jnslmk/freecad-models/led_profiles/stella/print/StellaOffsetCore-Organic offset triangular connector — three integrated saddles.stl

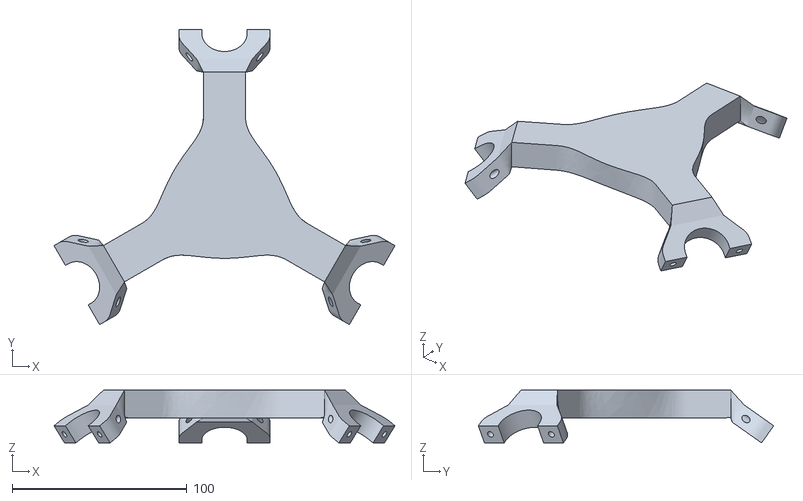
[picture p1: CAD file, 2026-09-25]
led_profiles/stella/print/StellaOffsetCore-Organic offset triangular connector — three integrated saddles.stl
195.0 x 168.9 x 30.2
