jnslmk/freecad-models/led_profiles/stella/stella_profile_sources/endcap_near.step

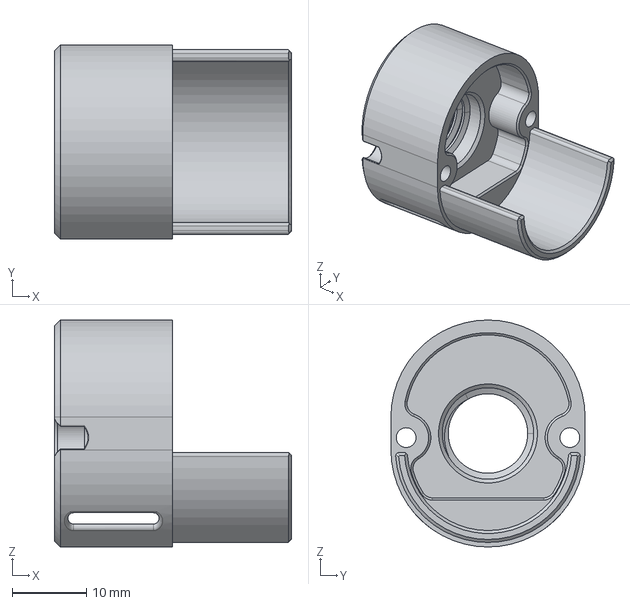
[picture p2: CAD file, 2026-09-22]
led_profiles/stella/stella_profile_sources/endcap_near.step
31.9 x 26.1 x 30.5 mm
