jnslmk/freecad-models/led_profiles/stella/stella_profile_sources/profile_diffuser.step

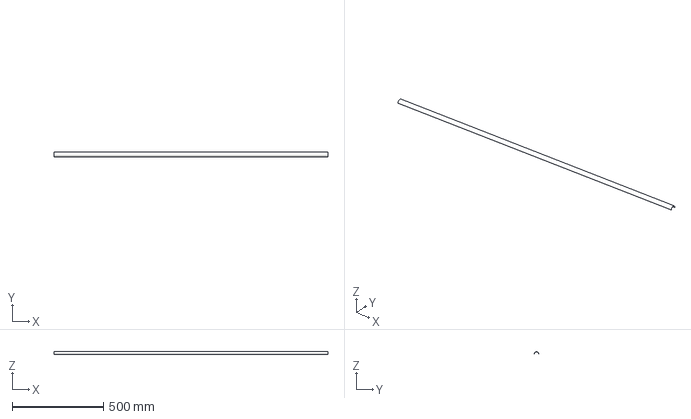
[picture p3: CAD file, 2026-09-22]
led_profiles/stella/stella_profile_sources/profile_diffuser.step
1500.0 x 26.1 x 13.7 mm
