jnslmk/freecad-models/led_profiles/stella/StellaCore.FCStd

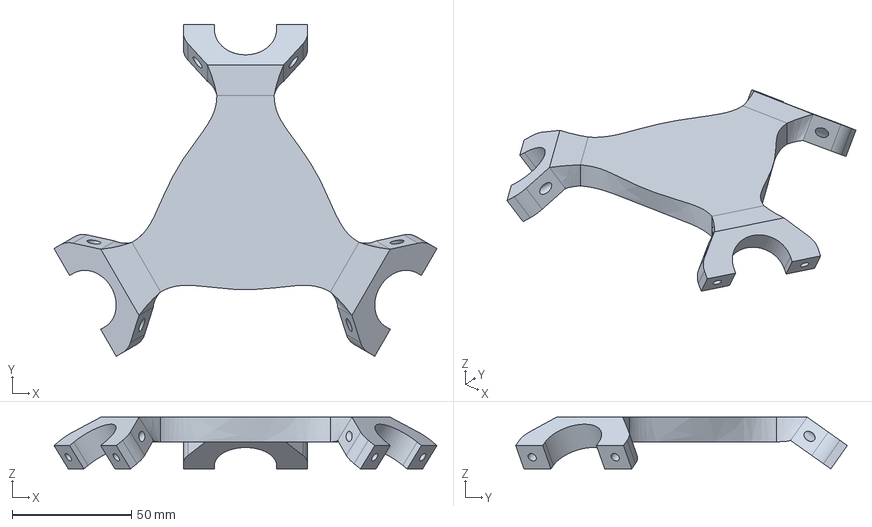
[picture p4: CAD file, 2026-09-25]
led_profiles/stella/StellaCore.FCStd
160.5 x 139.0 x 21.7 mm
