jnslmk/freecad-models/led_profiles/stella/stella_profile_sources/cable_far.step

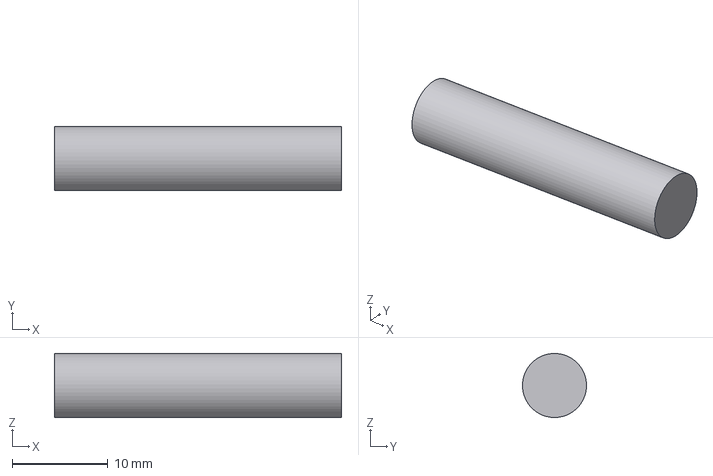
[picture p5: CAD file, 2026-09-22]
led_profiles/stella/stella_profile_sources/cable_far.step
30.0 x 6.70 x 6.69 mm
