jnslmk/freecad-models/led_profiles/stella/StellaOctangula.FCStd

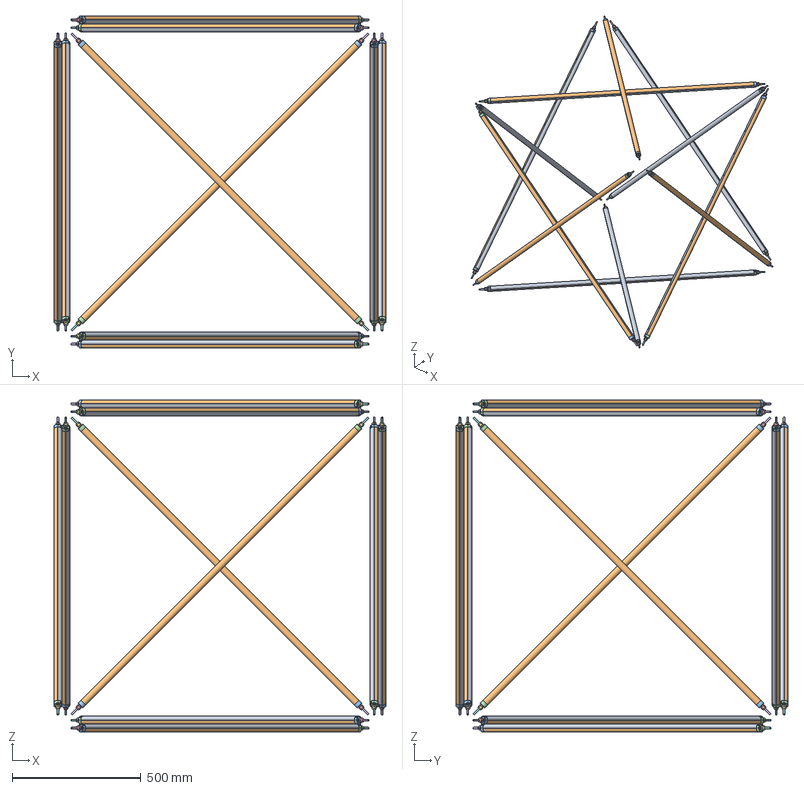
[picture p6: CAD file, 2026-09-24]
led_profiles/stella/StellaOctangula.FCStd
1288.4 x 1288.4 x 1288.4 mm
Aluminium profile x 12
Diffuser x 12
Near endcap x 12
Far endcap x 12
Near cable gland x 12
Near cable stub x 12
Far cable gland x 12
Far cable stub x 12
