jnslmk/freecad-models/led_profiles/stella/StellaProfileClamp.FCStd

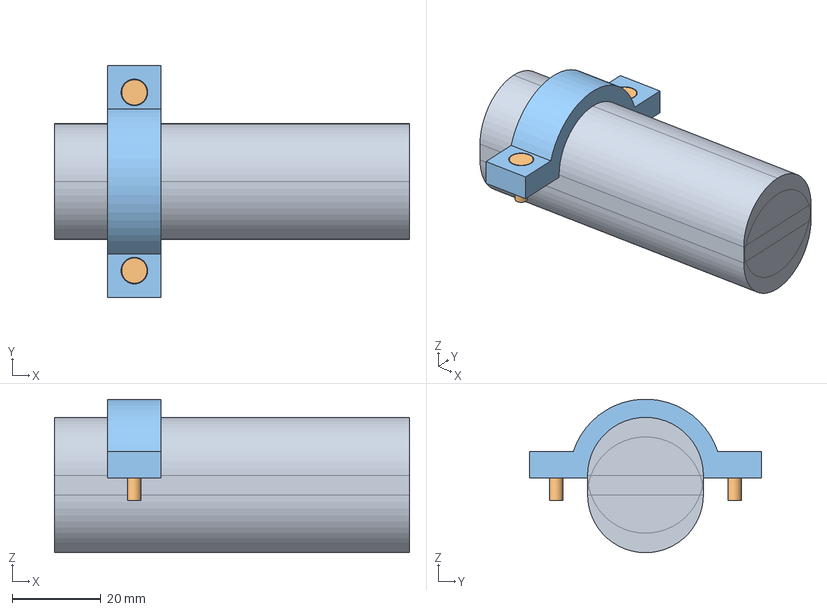
[picture p7: CAD file, 2026-09-24]
led_profiles/stella/StellaProfileClamp.FCStd
80.0 x 52.2 x 34.6 mm
Reference-only measured LED profile — 26.1 × 30.5 mm
Two M3 × 8 socket-head screws — clamp-side insertion reference
Simplified Stella profile clamp
