jnslmk/freecad-models/led_profiles/stella/stella_profile_sources/gland_near.step

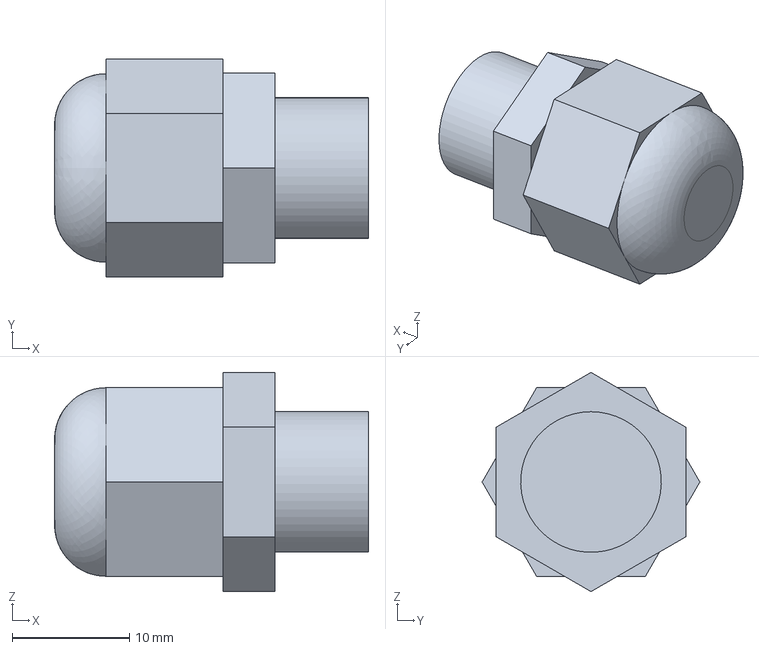
[picture p8: CAD file, 2026-09-22]
led_profiles/stella/stella_profile_sources/gland_near.step
26.8 x 18.6 x 18.7 mm
