jnslmk/freecad-models/led_profiles/stella/stella_profile_sources/profile_extrusion.step

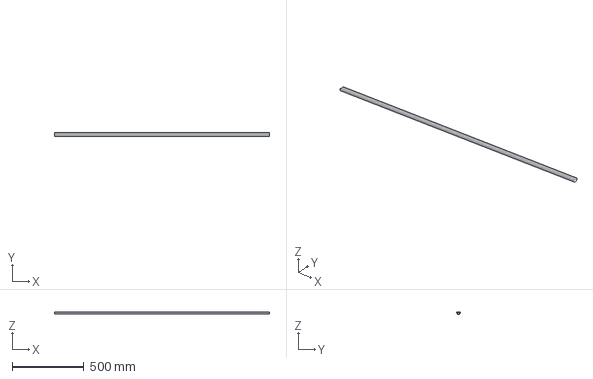
[picture p9: CAD file, 2026-09-22]
led_profiles/stella/stella_profile_sources/profile_extrusion.step
1500.0 x 26.1 x 16.8 mm
