jnslmk/freecad-models/(list of files, cad)

Other CAD files:
led_profiles/stella/StellaOffsetCore.FCStd
led_profiles/stella/stella_profile_sources/cable_near.step
led_profiles/stella/stella_profile_sources/endcap_far.step
led_profiles/stella/stella_profile_sources/gland_far.step
led_profiles/stella/print/StellaCore.stl
