jnslmk/freecad-models/(commit log)

2026-09-22 chore: initialize freecad models repository
    [StellaArm.FCStd, StellaArm.before-scope-fix.FCStd, StellaCore.FCStd, StellaOctangula.FCStd]
2026-09-22 fix(stella): harden assembly rebuild workflow
2026-09-22 feat(stella): add profile clamp assembly
    [StellaArm.FCStd, StellaCore.FCStd, StellaProfileClamp.FCStd]
2026-09-22 refactor(stella): simplify profile clamp tree
    [StellaProfileClamp.FCStd]
2026-09-22 feat(stella-arm): add arm mounting features
    [StellaArm.FCStd]
2026-09-22 refactor(stella-clamp): remove duplicate primitives
    [StellaProfileClamp.FCStd]
2026-09-22 refactor(stella): pattern core seats
    [StellaCore.FCStd, StellaCore.before-simplification.FCStd]
2026-09-22 chore(stella): update arm model
    [StellaArm.FCStd]
2026-09-22 feat(stella): assemble complete profile sources
    [StellaArm.FCStd, StellaOctangula.FCStd, StellaOctangula.before-full-profile.FCStd, StellaOctangula.before-validation-note.FCStd, cable_far.step, cable_near.step, endcap_far.step, endcap_near.step]
2026-09-23 docs(stella): record assembly design baseline
    Capture native source-of-truth objects, fixed interfaces, measured fit gaps, and useful views before revising geometry. No authoritative FCStd document is changed.
2026-09-23 feat(stella): stage clamped assembly review
    Seat linked arms against the intended 12 mm core, include 24 linked native clamps, and reject joint gaps or clamp interference. Preserve the four authoritative FCStd files; save a separate functional working copy and an unselected native-filleted clamp concept. Envelope, crossings, and cable route remain open decisions.
    [StellaOctangula-12mm-clamps.FCStd, StellaOctangula-ConceptA.FCStd, StellaProfileClamp-ConceptA.FCStd]
2026-09-23 feat(stella): accept offset-core assembly
    [StellaArm.FCStd, StellaArm.stl, StellaCore.FCStd, StellaCore.stl, StellaCoreSimple.FCStd, StellaOctangula-12mm-clamps.FCStd, StellaOctangula-ConceptA.FCStd, StellaOctangula-before-12mm-acceptance.FCStd]
2026-09-24 feat(stella): publish compact simple assembly
    [StellaCoreSimple-Compact-PETG.FCStd, StellaCoreSimple-ConceptA.FCStd, StellaCoreSimple-ConceptB.FCStd, StellaCoreSimple-Offset-Compact-PETG.FCStd, StellaCoreSimple-Offset-before-bolted-clamps-20260923.FCStd, StellaCoreSimple-Offset.FCStd, StellaCoreSimple-before-bolted-clamps-20260923.FCStd, StellaCoreSimple-before-channel-clearance-20260923.FCStd]
2026-09-24 chore(stella): consolidate canonical models
    [StellaArm.FCStd, StellaArm.before-scope-fix.FCStd, StellaCore.FCStd, StellaCore.before-simplification.FCStd, StellaCoreSimple-Compact-PETG.FCStd, StellaCoreSimple-ConceptA.FCStd, StellaCoreSimple-ConceptB.FCStd, StellaCoreSimple-Offset-Compact-PETG.FCStd]
2026-09-24 docs(agents): use one-document CAD reviews
2026-09-24 feat(stella): integrate mirrored saddle mounts
    [StellaCore.FCStd]
2026-09-24 fix(stella): keep insert pilots centered in grips
    [StellaCore.FCStd]
2026-09-24 docs(cad): require relational design constraints
2026-09-24 feat(stella): parameterize base triangle height
    [StellaCore.FCStd]
2026-09-24 feat(stella): bridge web to clamp with pipe
    [StellaCore.FCStd]
2026-09-24 fix(stella): align offset core clamps
    [StellaOctangula.FCStd, StellaOffsetCore.FCStd]
2026-09-25 fix(stella): add through-hole clamp bores
    [StellaCore.FCStd, StellaCore.stl, StellaOffsetCore.FCStd]
2026-09-25 fix(stella): constrain web transition sketch
    [StellaCore.FCStd]
2026-09-25 feat(stella): update offset connector model
    [StellaArm.stl, StellaOffsetCore-Organic offset triangular connector — three integrated saddles.stl, StellaOffsetCore.FCStd]
2026-09-26 chore: gitignore .stl files
2026-09-26 feat(wled): snapshot Edge Relay and controller config
2026-10-01 Use native CAD meshes in Stella preview
2026-10-01 Point Stella exhibition preview stream at BeamHouse 6455
    BeamHouse now listens on UDP 6455 by default (GLED owns 6454
    for its Art-Net input), so the preview device needs the
    explicit port or the visualizer stays dark.
